suniala/MIDItriggs/(list of files, drawings)

Other design files:
hardware/cr-78-ram.pcb
hardware/drillmask.pcb
hardware/miditriggs-harp-1.pcb
hardware/miditriggs-harp-2.pcb
